longnbk4/5dof-roboticarm-control/file ảnh khối lượng/bf65dcab-9455-42fa-a85e-1a6926353547.jpg

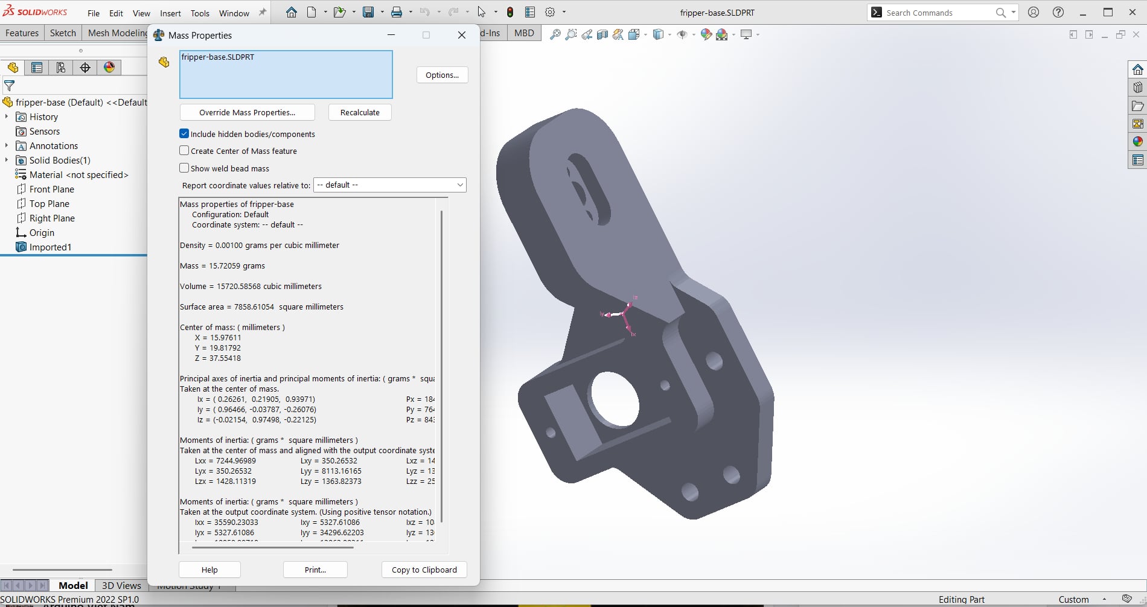
file ảnh khối lượng/bf65dcab-9455-42fa-a85e-1a6926353547.jpg
