longnbk4/5dof-roboticarm-control/file ảnh khối lượng/d0caaeba-334b-4f38-8ba2-407e9ea374a1.jpg

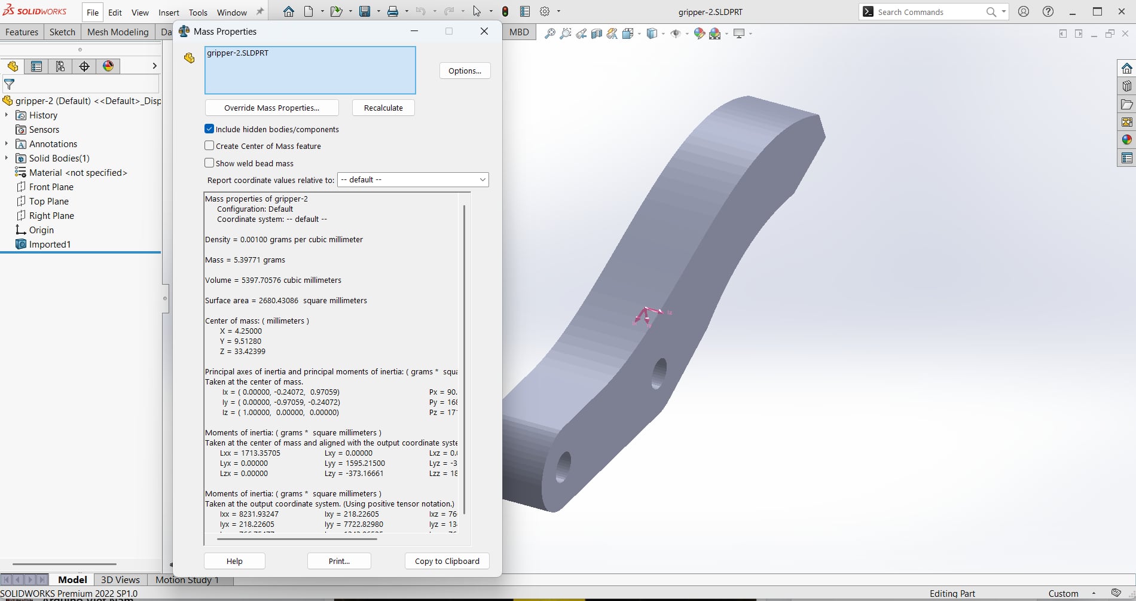
file ảnh khối lượng/d0caaeba-334b-4f38-8ba2-407e9ea374a1.jpg
