longnbk4/5dof-roboticarm-control/README.md

# 5dof-roboticarm-control
Control and automate a 5 DOF robotic arm using Arduino and servo motors. Includes code, schematics, and motion sequences
