longnbk4/5dof-roboticarm-control/bao cao/báo-cáo-giữa-kì-cơ-cấu-truyền-động.pdf

BÁO CÁO GIỮA KÌ CƠ CẤU TRUYỀN ĐỘNG

MÔ PHỎNG ĐIỀU KHIỂN VỊ TRÍ CỦA ĐỘNG CƠ ENCODER SỬ DỤNG PID

Nguyễn Huy Thắng - 22027545 Nguyễn Bảo Long- 22027537
Trần Hoàng Thắng- 22023160

Tóm tắt: Mục tiêu chính của bài báo cáo là điều khiển vị trí của động cơ DC có gắn Encoder bằng cách sử dụng PID. PID sẽ hiệu chỉnh sai số giữa vị trí đã đo và vị trí mong muốn, tính toán lỗi và sau đó cấp tín hiệu điều điện áp đề điều chỉnh độ rộng xung để trả về kết quả phù hợp. Các tham số Kp, Kd, Ki được tinh chỉnh bằng phương pháp thử.

Từ khoá: Encoder, Quadrature Encoder, DC motor, điều khiển PID, tinh chỉnh PID

I. Giới thiệu
1. Động cơ Encoder

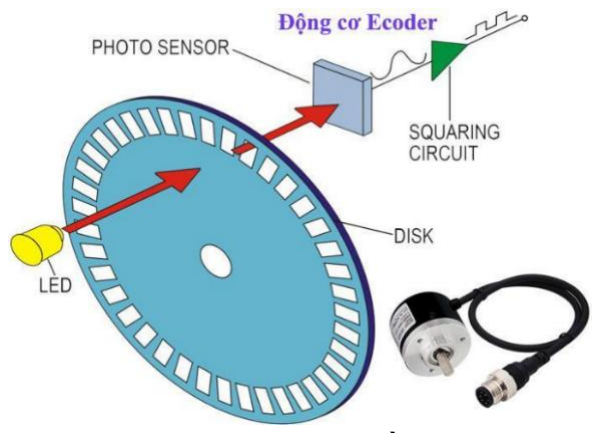
[picture p3: figure]

- Động cơ encoder là tên một loại động cơ có phần con quay được tích hợp trong một hệ thống tự động nhằm mục đích tạo tín hiệu xung trong hoạt động điều khiển động cơ hoặc máy móc.
- Encoder (bộ mã hoá) còn gọi là Quadrature Encoder, Linear Encoder, Rotary Encoder… mục đích là thực hiện mã hoá số vòng quay nhằm mục đích tạo tín hiệu xung có dạng vuông trong quá trình điều khiển động cơ.
- Dựa trên sơ đồ tín hiệu có dạng nhị phân các dòng encoder có thể hỗ trợ hoán đổi vị trí góc hoặc vị trí thẳng căn cứ theo yêu cầu sử dụng có mong muốn di chuyển đến vị trí điều khiển như thế nào.
2. Nguyên lý hoạt động
- Động cơ nhận tín hiệu điều khiển điện áp Vapp, sinh ra dòng điện I và sinh ra mô men quay T tạo ra chuyển động quay (θ, ω).

- Bộ mã hoá encoder được gắn trực tiếp lên trục động cơ đo lường và cung cấp phản hồi thời gian thực về vị trí góc (θ, ω).
- Trong miền Laplace, hàm truyền đặc trưng của hệ thống điều khiển vị trí là từ điện áp đặt Vapp(s) đến đầu ra vị trí θ(s).
- Tín hiệu phản hồi từ encoder (θ(t) sẽ so sánh với giá trị đặt (reference) để tạo sai số e(t), từ đó bộ điều khiển PID sẽ chỉnh lại điện áp điều khiển cho phù hợp.

Mô hình điều khiển động cơ encoder sử dụng PID

II. Yêu cầu thiết kế
- Vị trí motor cần chính xác, sai số trạng thái cần tiến đến 0. Hệ thống cần phản hồi nhanh. Mô phỏng sử dụng reference là động cơ bước và ta hi vọng kết quả trả về có settling time khoảng 40ms và overshoot nhỏ hơn 16%.

III. Mô hình toán học và mô phỏng điều khiển
1. Mô hình toán học vị trí của động cơ DC

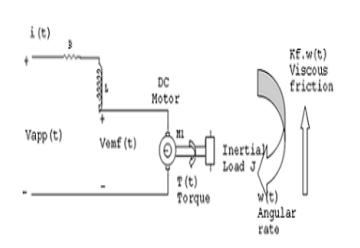
[picture p4: figure]

Cấu trúc của động cơ DC

Áp dụng định luật Kirchoff ta có:

Vapp = VL + VR + Vemf

Trong đó:

Vapp: điện áp cấp vào động cơ (V)

VL
: điện áp cuộn cảm (V)

VR: điện áp trở (V)

Vemf: suất điện động phản kháng (V)

⇔ Vapp(t) = L ⋅

di
dt + R ⋅ i(t) + e

⇔ Vapp(t) = L ⋅

di
dt + R ⋅ i(t) + Ke

⋅ θ̇(1)

Áp dụng định luật Newton ta có:

J ⋅ θ̈+ b ⋅ θ̇ = T = Kt
⋅ i (2)

Trong đó:

T: tổng mô men tác dụng lên trục quay (Nm)

J: mô men quán tính của vật quay (kgm²
)

θ̈: gia tốc quay (rad/s²
)

Tđộng cơ = Kt

⋅ i: mô men sinh ra từ động cơ điện

Áp dụng biến đổi Laplace với hai phương trình (1) và (2) ta thu được hệ phương trình:

(Ls + R) ⋅ I(s) = V(s) − K ⋅ s ⋅ θ(s)

s(Js + b) ⋅ θ(s) = K ⋅ I(s)

Giải hệ phương trình trên ta được mối quan hệ giữa đầu vào V(s) và tốc độ quay đầu ra θ(s)

θ(s)
V(s)

=

K
(Js + b)(Ls + R) + K²

2. Mô phỏng điều khiển bằng Simulink

Động cơ DC nhận điện áp V(s) tạo ra mô men xoắn sinh ra chuyển động quay θ(s) từ 2 phần điện và phần cơ thông qua hàm truyền. Khối Encoder lấy ra giá trị góc quay để trả về nên khối động cơ DC motor và Encoder thay thế bằng khối hàm truyền

θ(s)
V(s)

=

K
(Js + b)(Ls + R) + K²

Với các giá trị cho trước như sau

J = 3.284E-6;

b = 3.5077E-6;

K = 0.0274;

R = 4;

L = 2.75E-6;

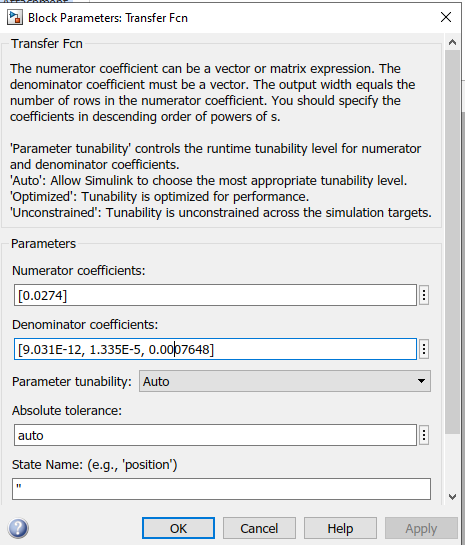
[picture p5: figure]

Ta thiết kế bộ điều khiển động cơ có Encoder với PID trên Matlab Simulink như sau

Mô hình điều khiển động cơ Encoder với PID

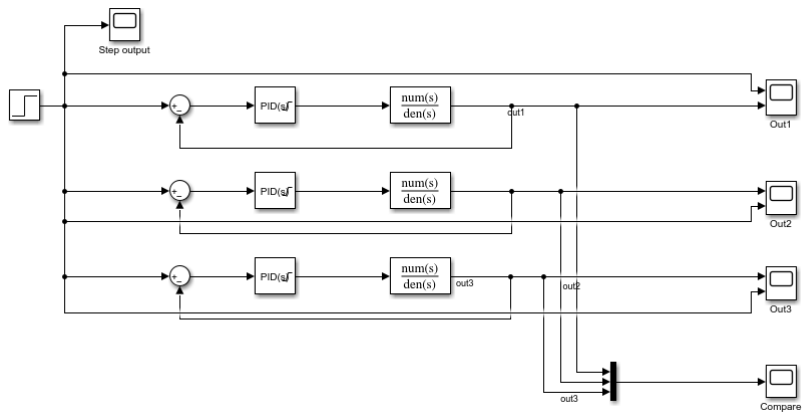
[picture p6: figure]

Mô hình với các PID khác nhau để thực hiện so sánh

Quy trình điều khiển hệ số PID có thể hiểu như sau

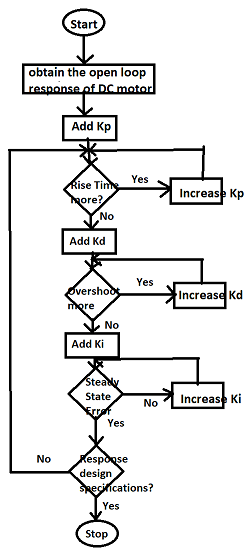
[picture p7: figure]

Sơ đồ tinh chỉnh hệ số PID

IV.Kết quả và nhận xét
1. Kết quả

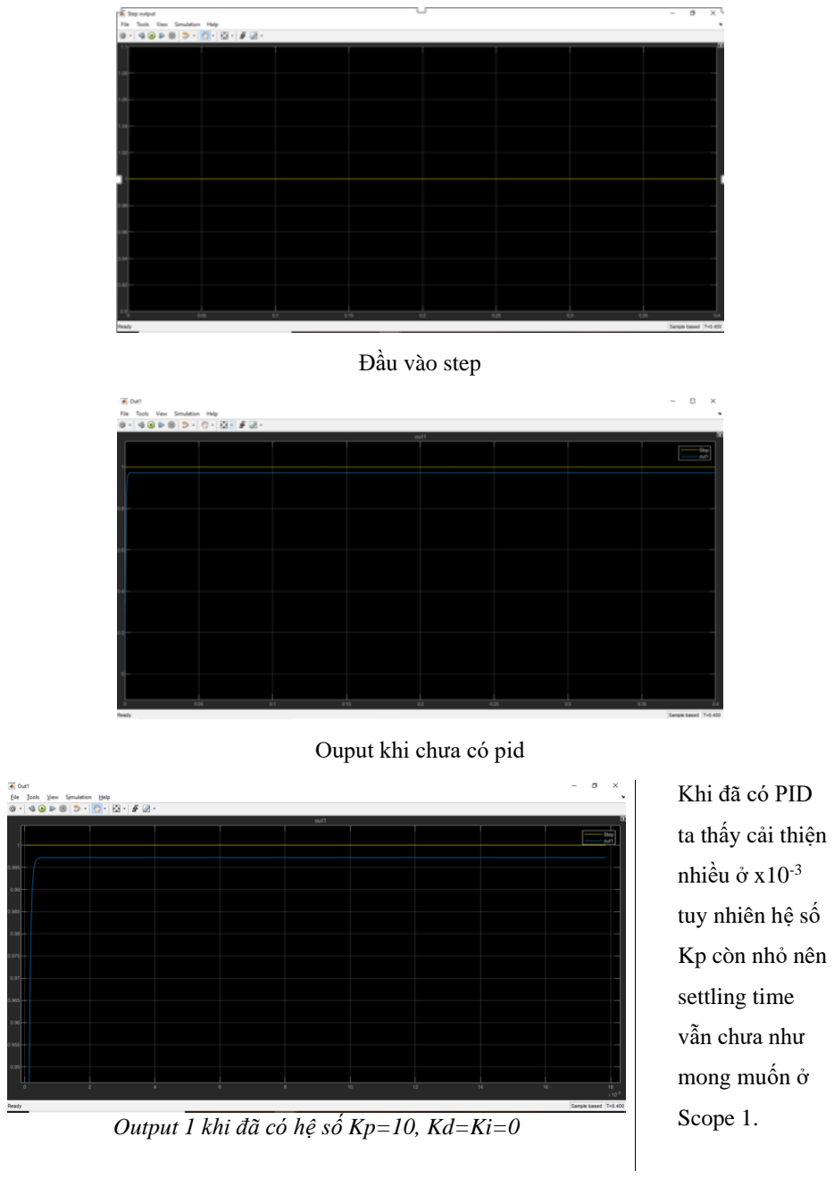
[picture p8: page 7]

Đầu vào step

Ouput khi chưa có pid

Output 1 khi đã có hệ số Kp=10, Kd=Ki=0

Khi đã có PID
ta thấy cải thiện

nhiều ở x10⁻³

tuy nhiên hệ số

Kp còn nhỏ nên

settling time
vẫn chưa như

mong muốn ở

Scope 1.

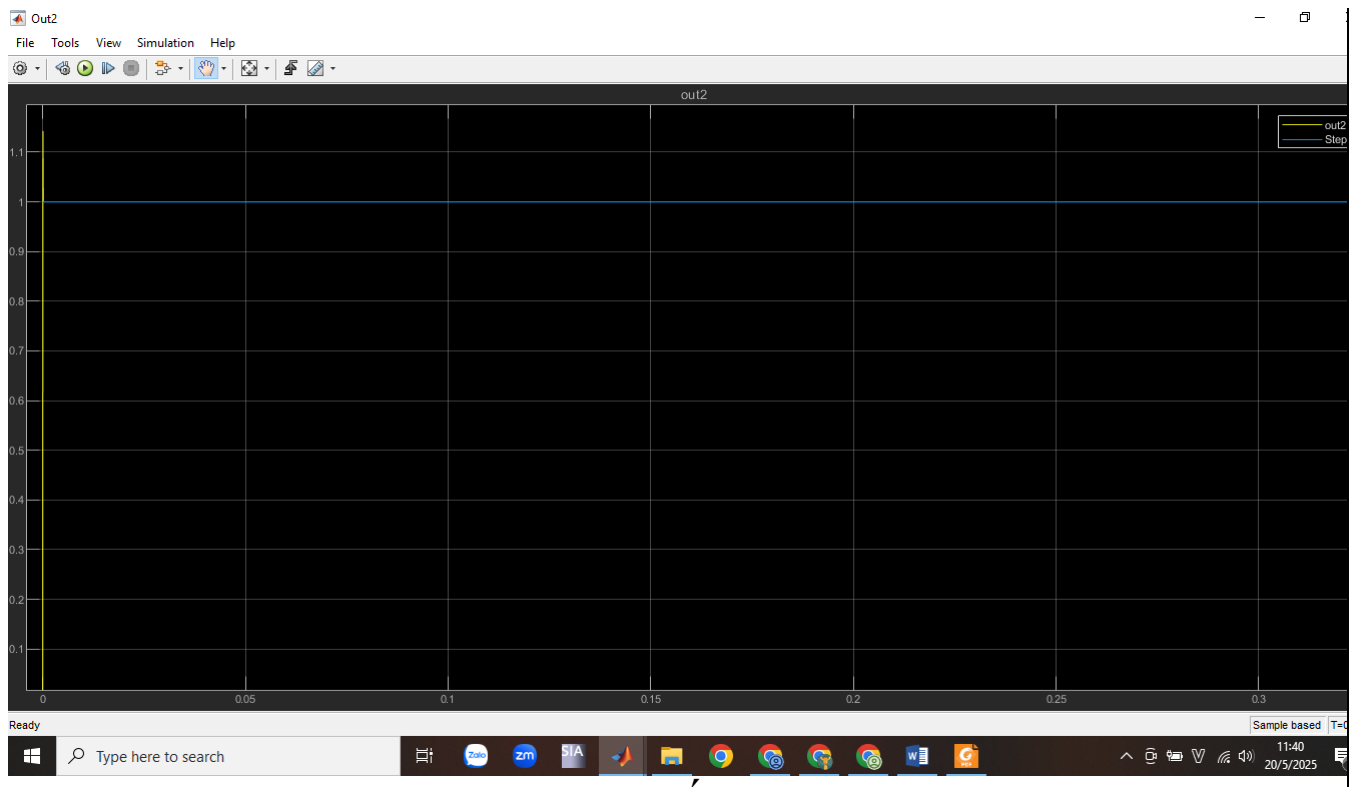
[picture p9: figure]

Output 2 khi Kp rất lớn, Kd=Ki=0

Ở scope 2
ta thấy
settlingtim
e đã giảm
tuy nhiên
Kp quá
lớn gây ra
overshoot
lớn ta cần
tinh chỉnh
thêm Kp
và Ki.

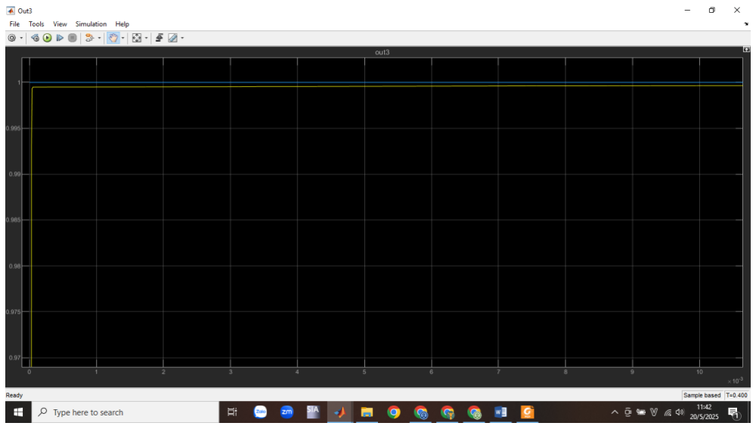
[picture p10: figure]

Ouput 3 sau khi tinh chỉnh Kp=100, Kd=300, Ki=0.35

Sau khi tinh

chỉnh cả 3 hệ
số Kp, Kd, Ki

ta thấy được

settling time

nhỏ như
mong muốn,

đồng thời hệ

thống không

bị overshoot.

Để trực quan hơn ta có thể so sánh 3 output khi tinh chỉnh các hệ số PID để so sánh bộ số PID nào là hiệu quả nhất

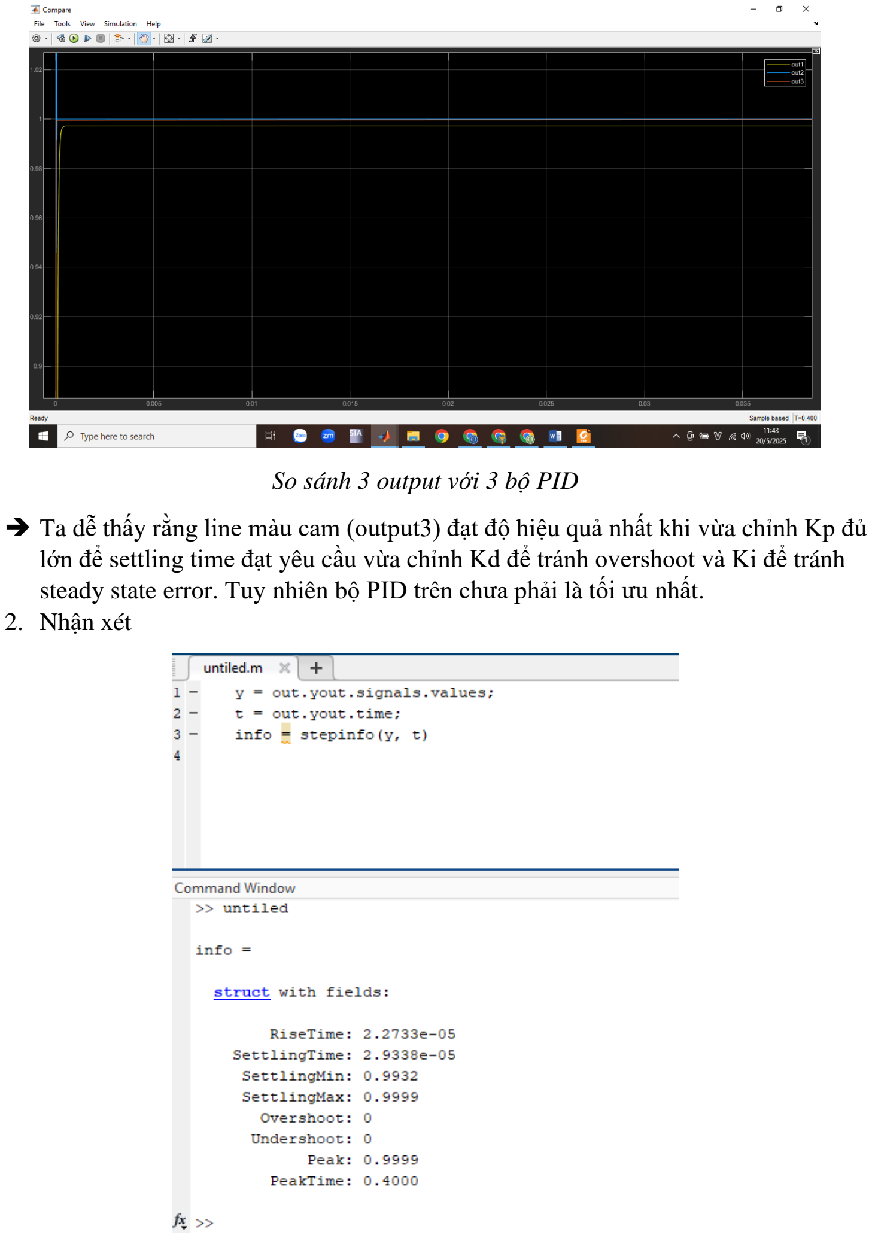
[picture p11: page 9]

So sánh 3 output với 3 bộ PID

➔ Ta dễ thấy rằng line màu cam (output3) đạt độ hiệu quả nhất khi vừa chỉnh Kp đủ lớn để settling time đạt yêu cầu vừa chỉnh Kd để tránh overshoot và Ki để tránh steady state error. Tuy nhiên bộ PID trên chưa phải là tối ưu nhất.
2. Nhận xét

Hệ thống thiết kế đạt yêu cầu khi Kp=100, Ki=300, Kd=0.35 với RiseTime và SettlingTime rất nhỏ xấp xỉ 2.8e-05 và Overshoot bằng 0.

Các thông số PID được chỉnh bằng phương pháp thử và kết quả mô phỏng cho thấy phương pháp trình bày đem lại kết quả tốt.

https://github.com/thangbnsh/Position-Control-of-DC-Motor-with-Encoder-using-PID-Simulation.git (https://github.com/thangbnsh/Position-Control-of-DC-Motor-with-Encoder-using-PID-Simulation.git)
