longnbk4/5dof-roboticarm-control/file ảnh khối lượng/0a03a622-1c0a-40e7-a4bd-0303fbc51710.jpg

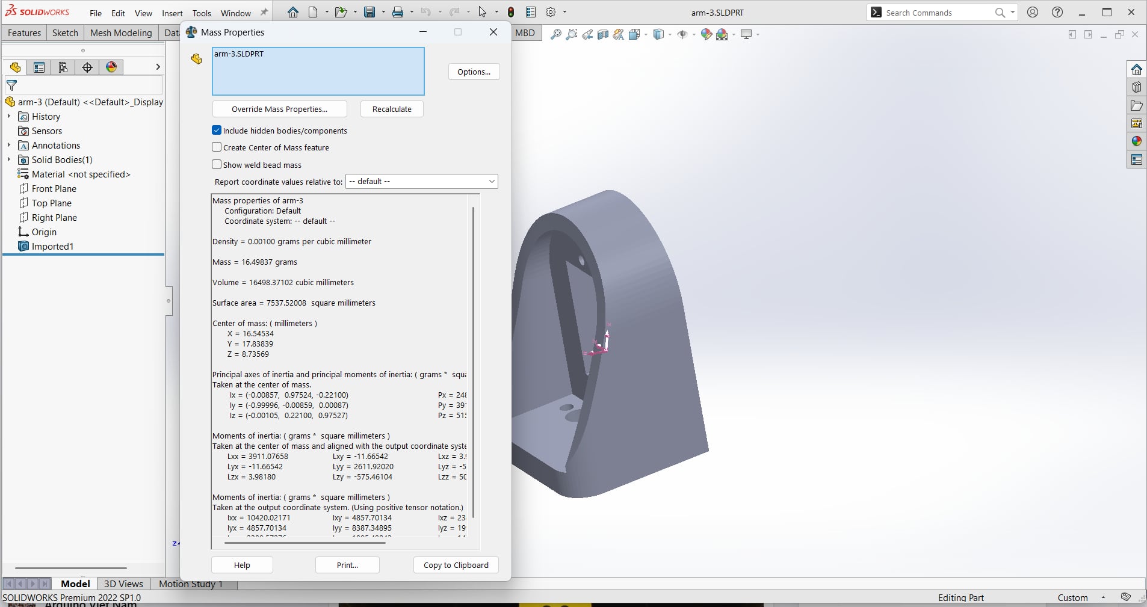
file ảnh khối lượng/0a03a622-1c0a-40e7-a4bd-0303fbc51710.jpg
