longnbk4/5dof-roboticarm-control/file ảnh khối lượng/58ed5dea-0e66-4e7b-8205-55d1e92b8d3d.jpg

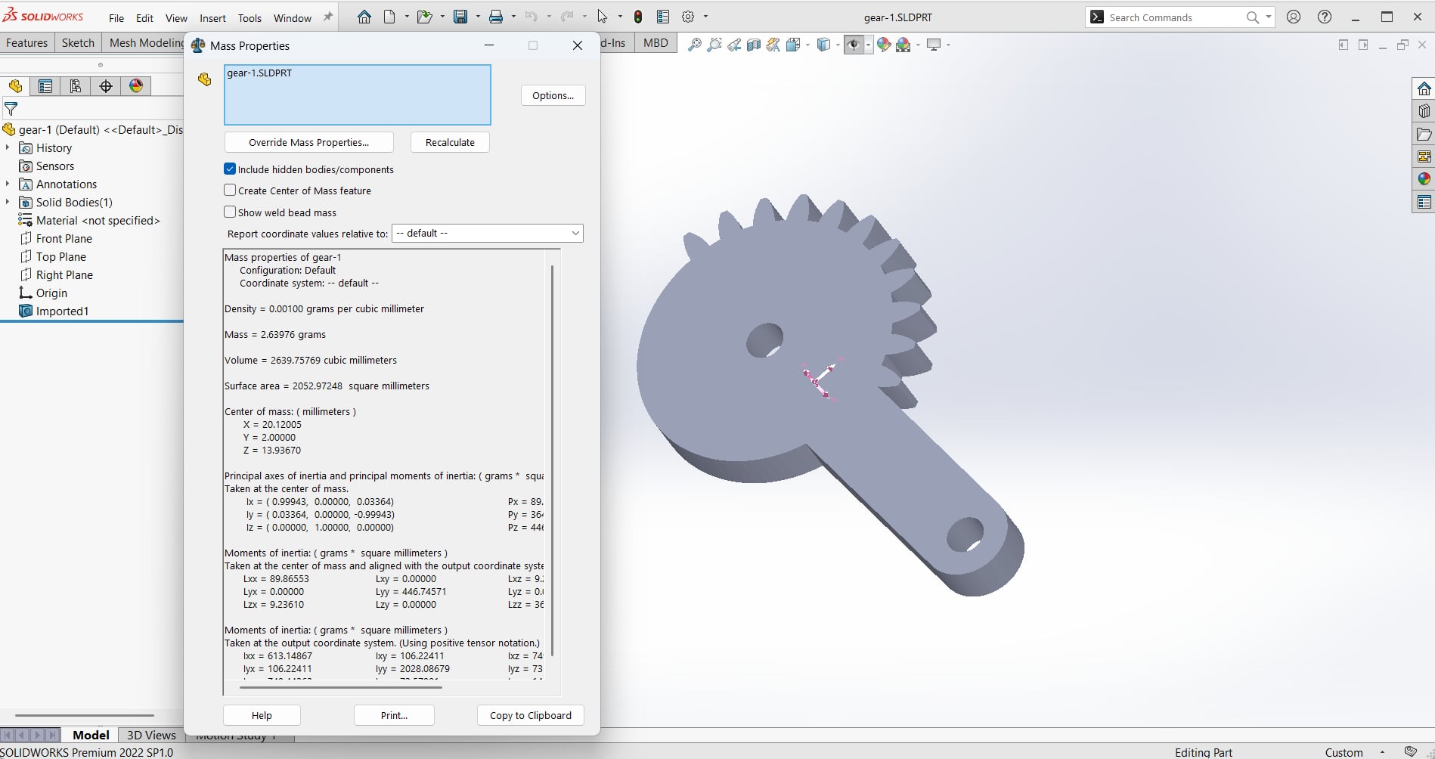
file ảnh khối lượng/58ed5dea-0e66-4e7b-8205-55d1e92b8d3d.jpg
