longnbk4/5dof-roboticarm-control/file ảnh khối lượng/147d4db0-71f6-4e1f-b58a-e63c4fb7e550.jpg

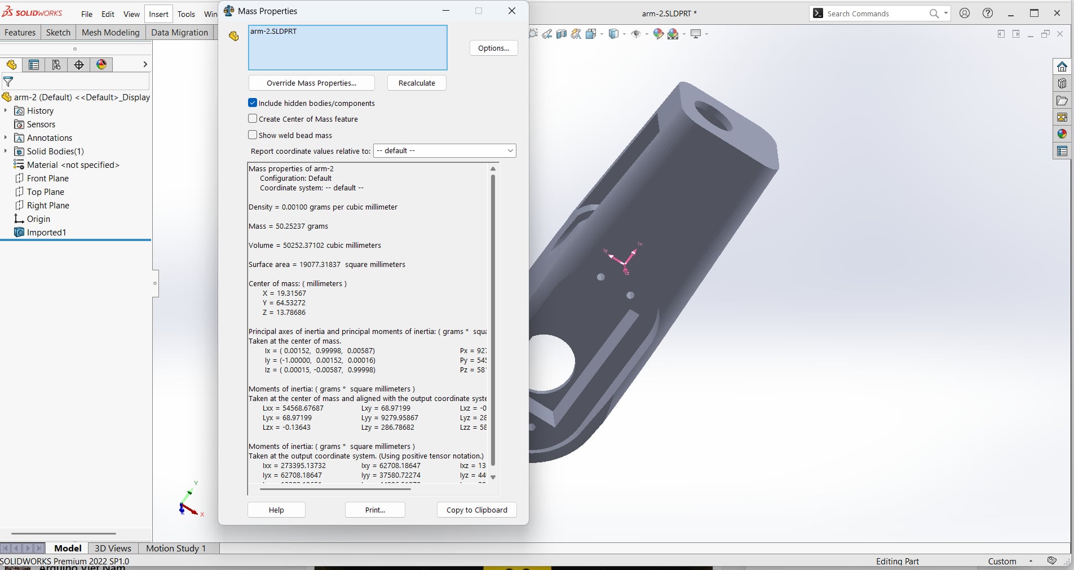
file ảnh khối lượng/147d4db0-71f6-4e1f-b58a-e63c4fb7e550.jpg
