longnbk4/5dof-roboticarm-control/file ảnh khối lượng/557fa58f-438f-42a1-a5a5-8b90d3aa8d0c.jpg

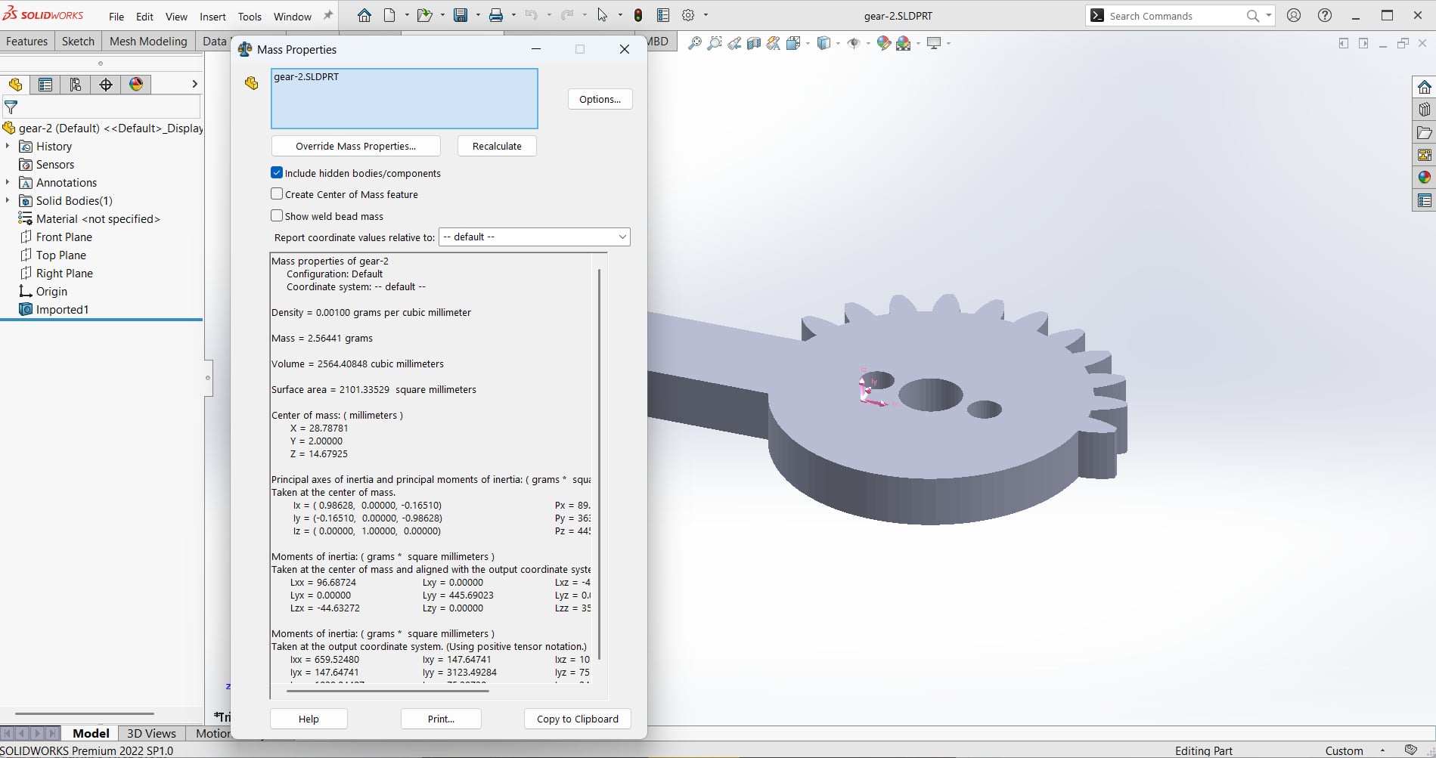
file ảnh khối lượng/557fa58f-438f-42a1-a5a5-8b90d3aa8d0c.jpg
