longnbk4/5dof-roboticarm-control/file ảnh khối lượng/86123e3b-c52b-41b8-b56e-a0a0c992bfe1.jpg

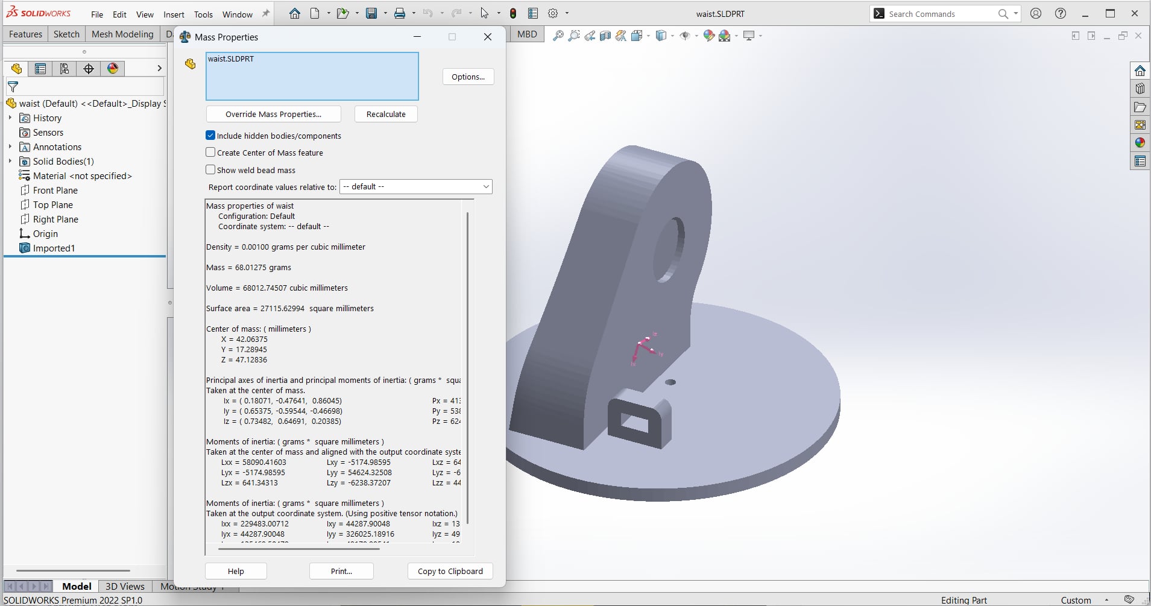
file ảnh khối lượng/86123e3b-c52b-41b8-b56e-a0a0c992bfe1.jpg
