longnbk4/5dof-roboticarm-control/file ảnh khối lượng/7778135b-bca0-4ba2-830c-3a51e6699cfc.jpg

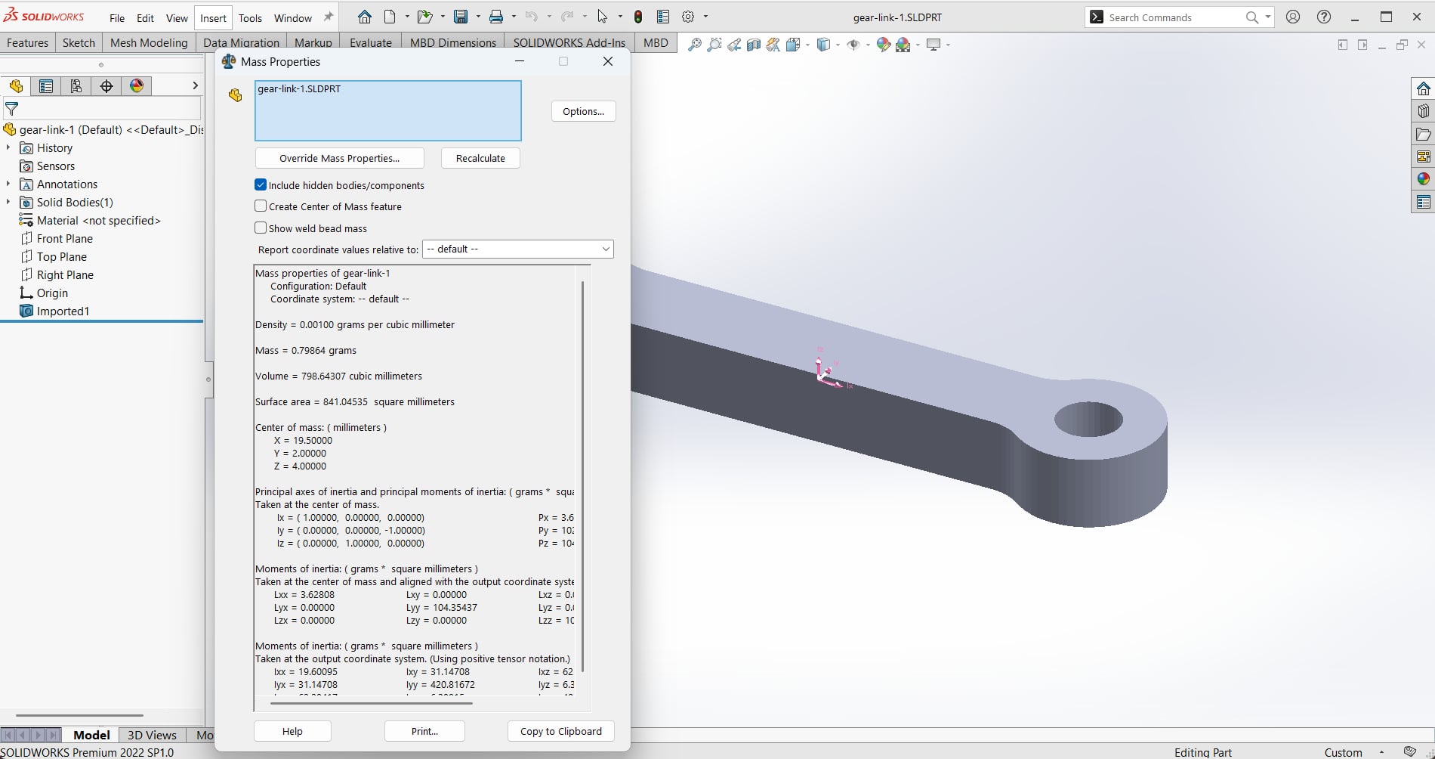
file ảnh khối lượng/7778135b-bca0-4ba2-830c-3a51e6699cfc.jpg
