longnbk4/5dof-roboticarm-control/file ảnh khối lượng/c1902829-240a-4d8c-8b65-bff52afb858e.jpg

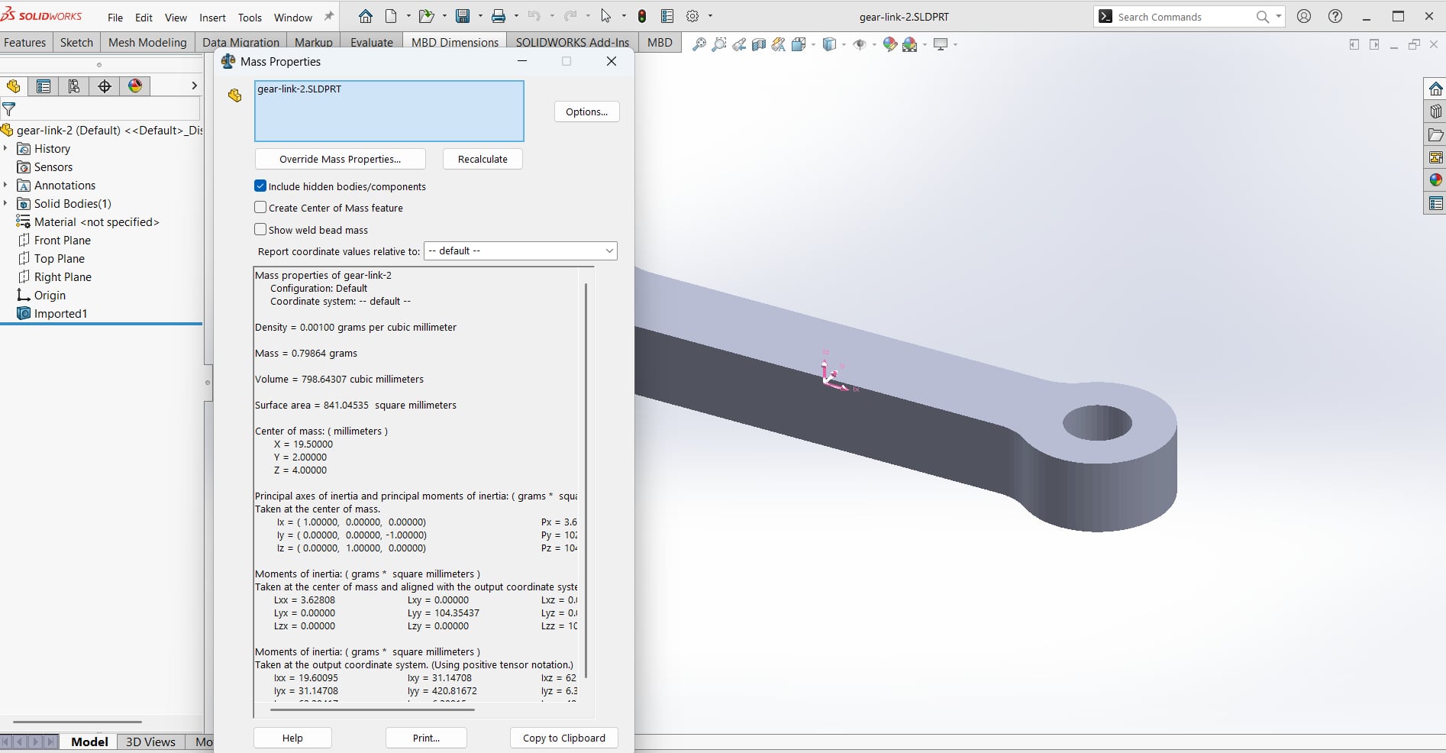
file ảnh khối lượng/c1902829-240a-4d8c-8b65-bff52afb858e.jpg
