longnbk4/5dof-roboticarm-control/file ảnh khối lượng/ce806592-2b92-44cc-8518-7352e3bb10ee.jpg

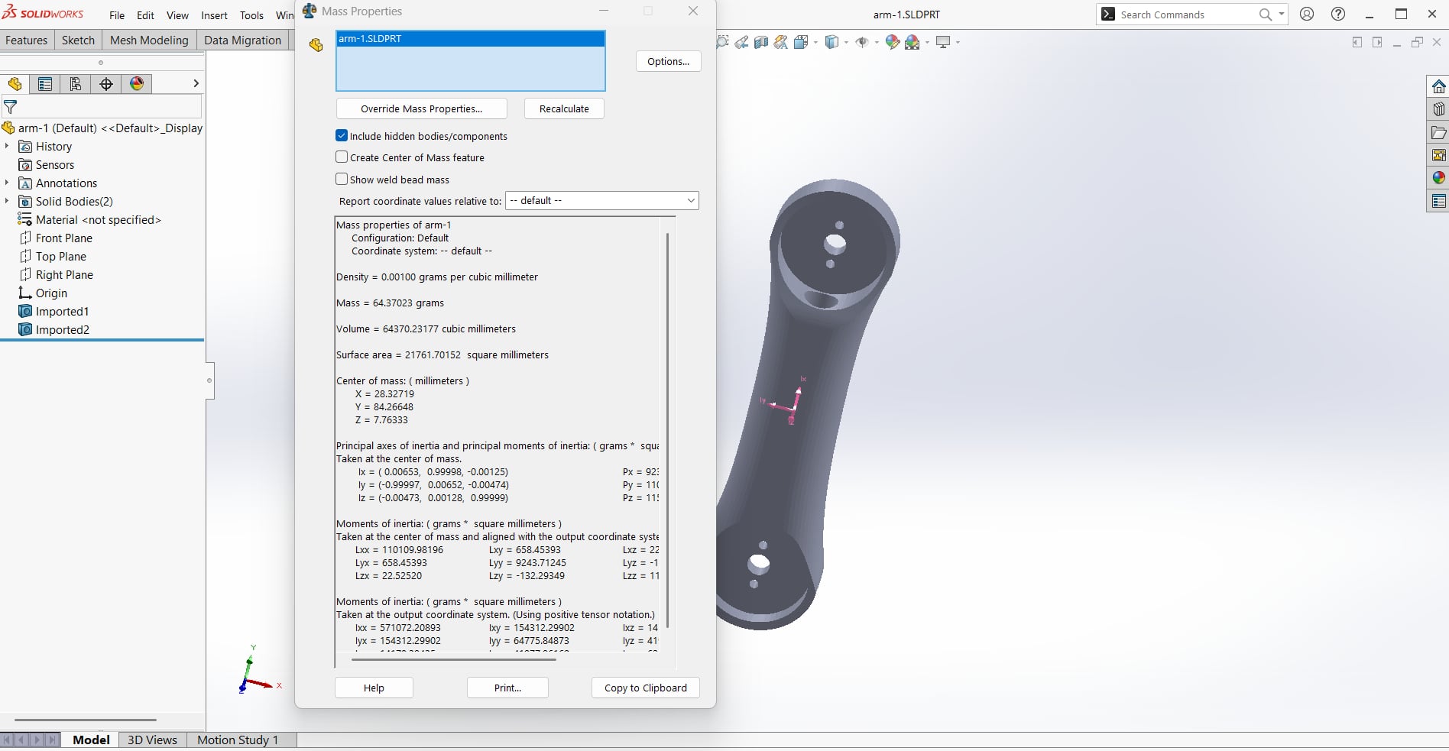
file ảnh khối lượng/ce806592-2b92-44cc-8518-7352e3bb10ee.jpg
