longnbk4/5dof-roboticarm-control/file ảnh khối lượng/cfc1959f-d5f5-47ed-b9dc-d4c9007c9d17.jpg

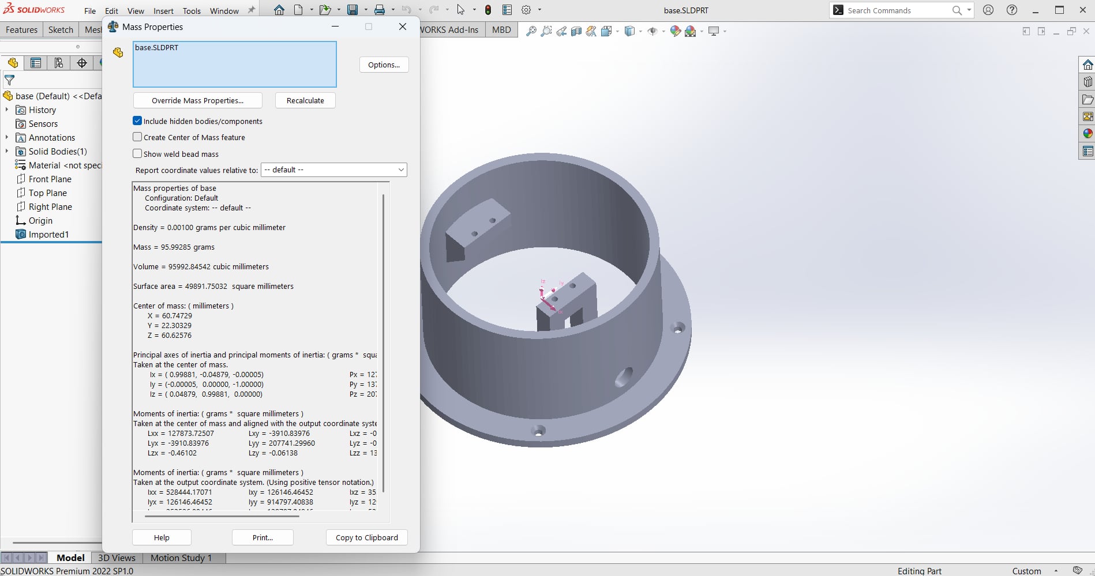
file ảnh khối lượng/cfc1959f-d5f5-47ed-b9dc-d4c9007c9d17.jpg
