longnbk4/5dof-roboticarm-control/file ảnh khối lượng/Screenshot 2025-05-21 174658.png

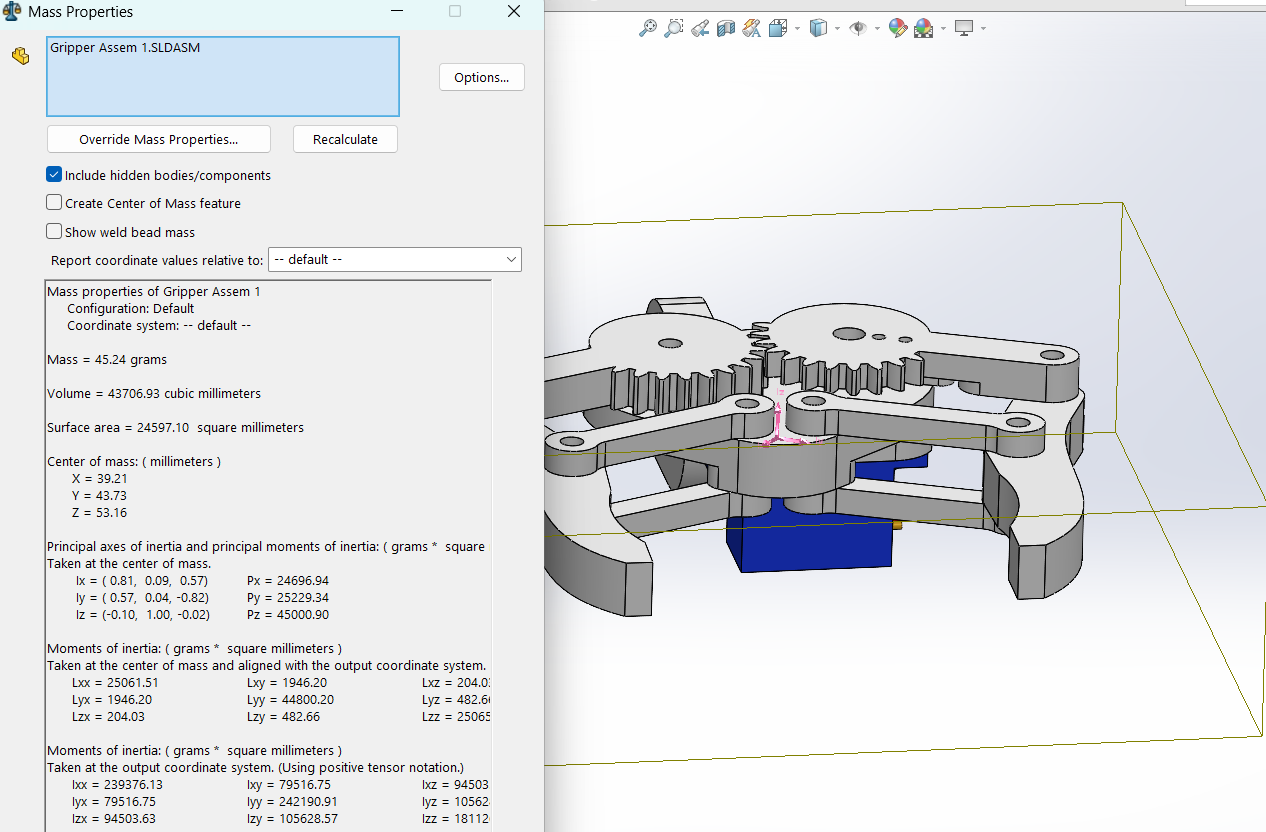
file ảnh khối lượng/Screenshot 2025-05-21 174658.png
