longnbk4/5dof-roboticarm-control/file ảnh sản phẩm tay máy/anh final.jpg

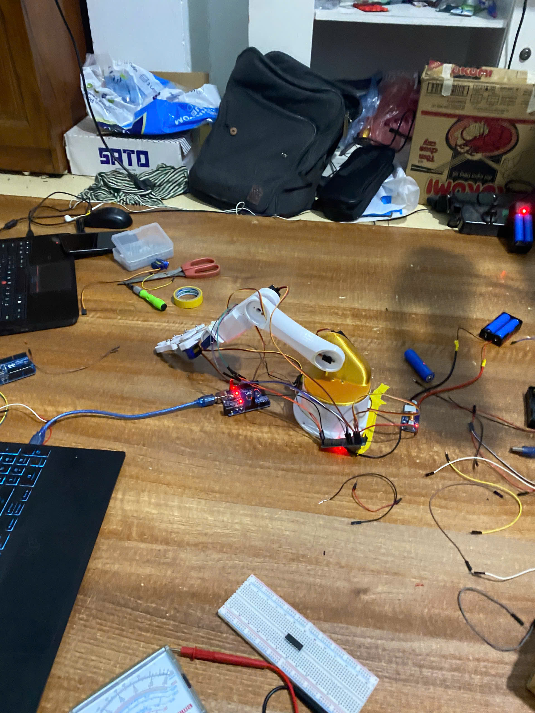
file ảnh sản phẩm tay máy/anh final.jpg
