longnbk4/5dof-roboticarm-control/file solid/arm-1.SLDPRT

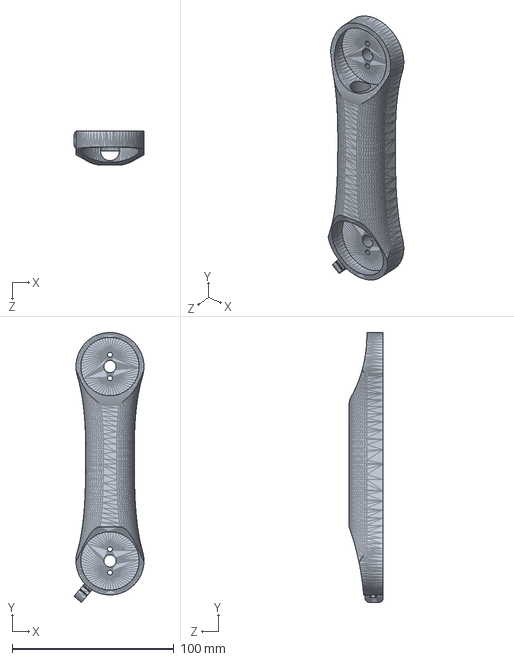
[picture p51: CAD file, 2025-06-09]
file solid/arm-1.SLDPRT
43.2 x 166.7 x 21.0 mm
