longnbk4/5dof-roboticarm-control/file solid/gear-2.SLDPRT

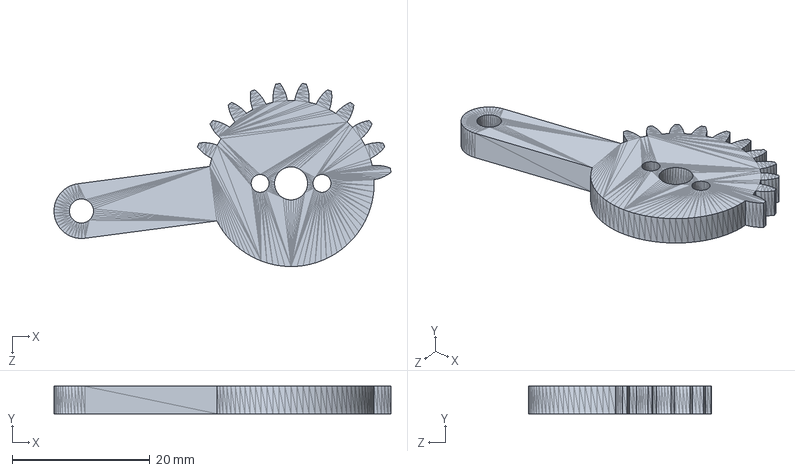
[picture p52: CAD file, 2025-06-09]
file solid/gear-2.SLDPRT
49.0 x 4.00 x 26.6 mm
