longnbk4/5dof-roboticarm-control/file solid/gripper-1.SLDPRT

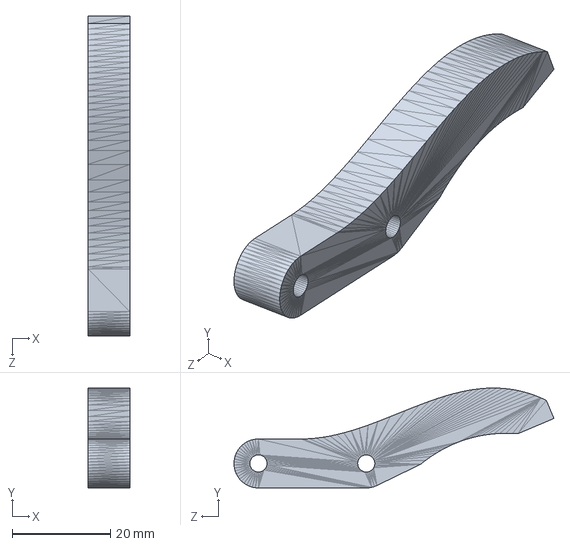
[picture p53: CAD file, 2025-06-09]
file solid/gripper-1.SLDPRT
8.50 x 20.4 x 65.3 mm
