longnbk4/5dof-roboticarm-control/file solid/waist.SLDPRT

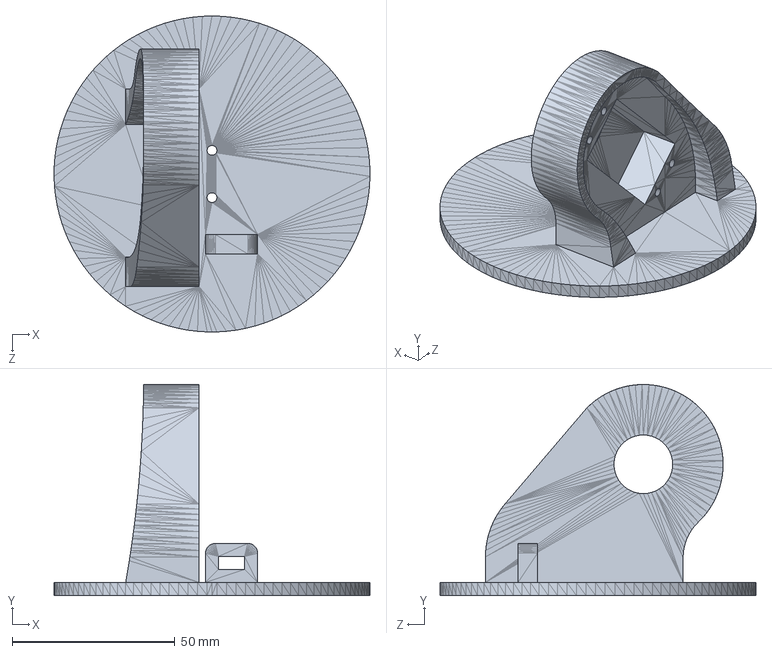
[picture p54: CAD file, 2025-06-09]
file solid/waist.SLDPRT
97.0 x 64.8 x 97.0 mm
