longnbk4/5dof-roboticarm-control/file solid/gear-link-1.SLDPRT

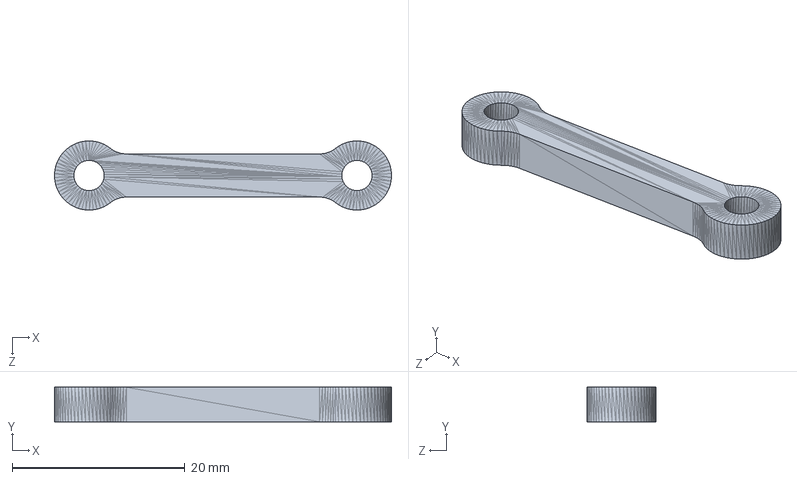
[picture p55: CAD file, 2025-06-09]
file solid/gear-link-1.SLDPRT
39.0 x 4.00 x 8.00 mm
