longnbk4/5dof-roboticarm-control/file solid/arm-3.SLDPRT

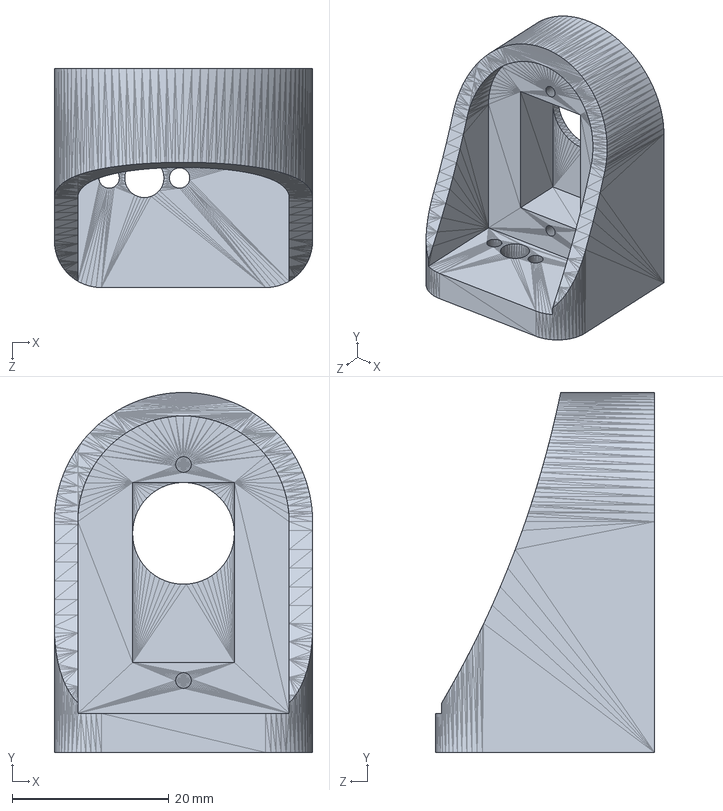
[picture p56: CAD file, 2025-06-09]
file solid/arm-3.SLDPRT
33.0 x 46.0 x 28.0 mm
