longnbk4/5dof-roboticarm-control/file solid/base.SLDPRT

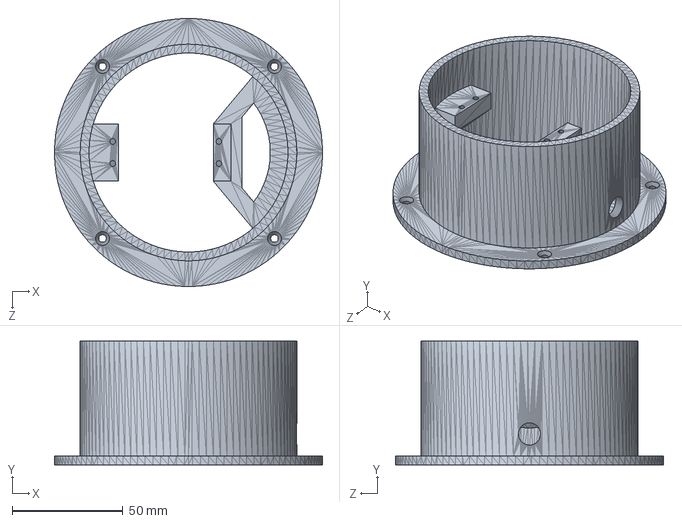
[picture p57: CAD file, 2025-06-09]
file solid/base.SLDPRT
121.2 x 56.0 x 121.2 mm
