longnbk4/5dof-roboticarm-control/file solid/fripper-base.SLDPRT

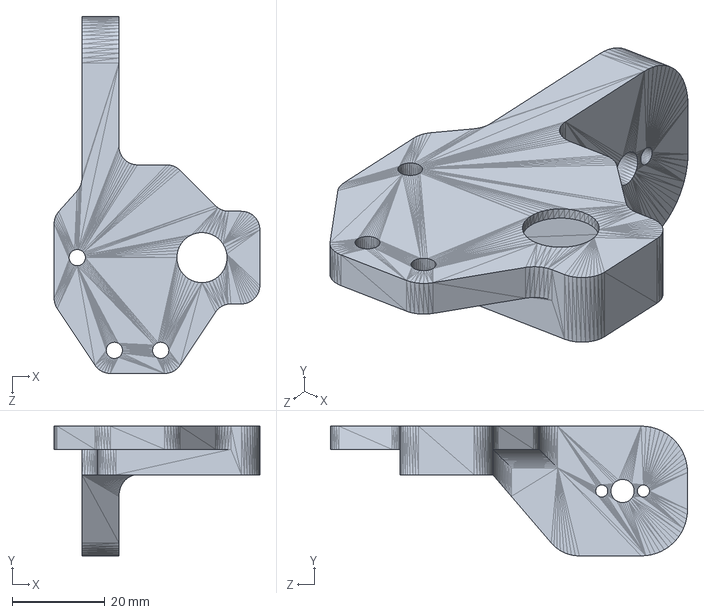
[picture p58: CAD file, 2025-06-09]
file solid/fripper-base.SLDPRT
44.4 x 28.0 x 77.0 mm
