longnbk4/5dof-roboticarm-control/file solid/arm-2.SLDPRT

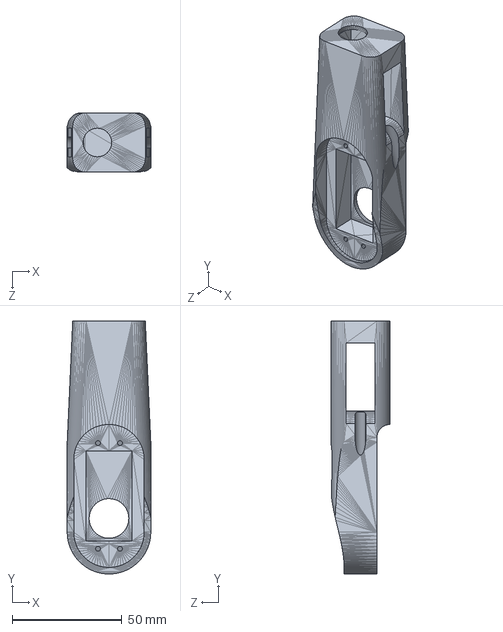
[picture p59: CAD file, 2025-06-09]
file solid/arm-2.SLDPRT
38.0 x 115.0 x 27.0 mm
