longnbk4/5dof-roboticarm-control/(list of files, cad)

Other CAD files:
file solid/gear-1.SLDPRT
file solid/gear-link-2.SLDPRT
file solid/gripper-2.SLDPRT
